mdouchement/Alembic-F2b/VPump/README.md

# VPump

The TT VPUMP kit is a very effective working voltage converter which generates an output voltage of 90 V DC to 220 V DC  from a 12V DC input voltage.
The circuit is in use for many years now and it is proven. In this kit the circuit has been adapted to a compact size and optimized for use in small preamplifier chassis. So it is an ideal HV power supply for tube stompboxes and preamps without the need of additional transformers and HV filter capacitors.

The VPump can be operated with a standard 12V DC switching power supply.
The switching power supply is not included in the kit. 

## Specification

Input Voltage: 12 V DC @ min 4 VA
Output Voltage: 90 - 220 V DC, adjustable
Output Current: 15 mA @ 220 V DC max 

## Link

https://www.tube-town.net/ttstore/tt-vpump-voltage-converter.html
