mdouchement/Alembic-F2b/potentiometer.png

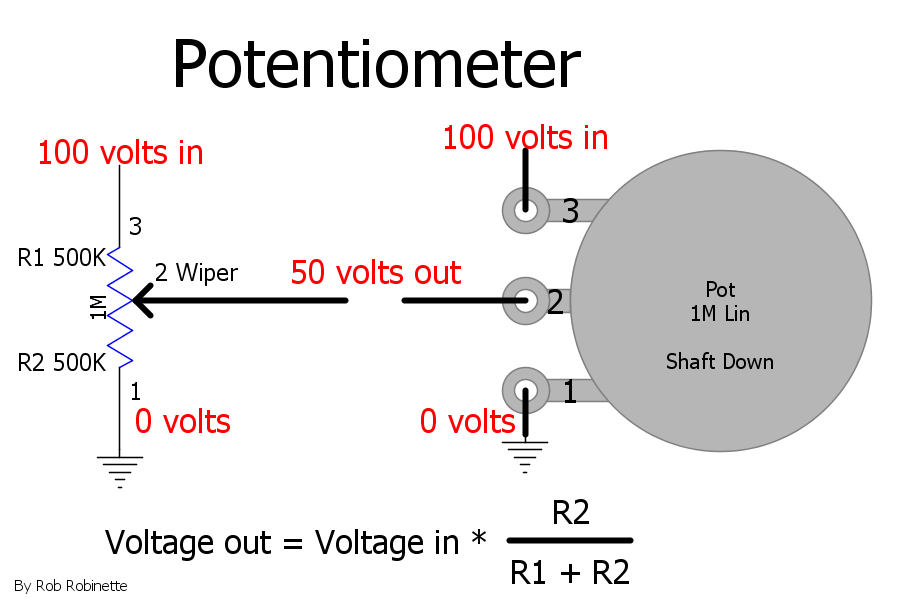
potentiometer.png
