mdouchement/Alembic-F2b/Alembic_F2b_bass_preamp_layout.pdf

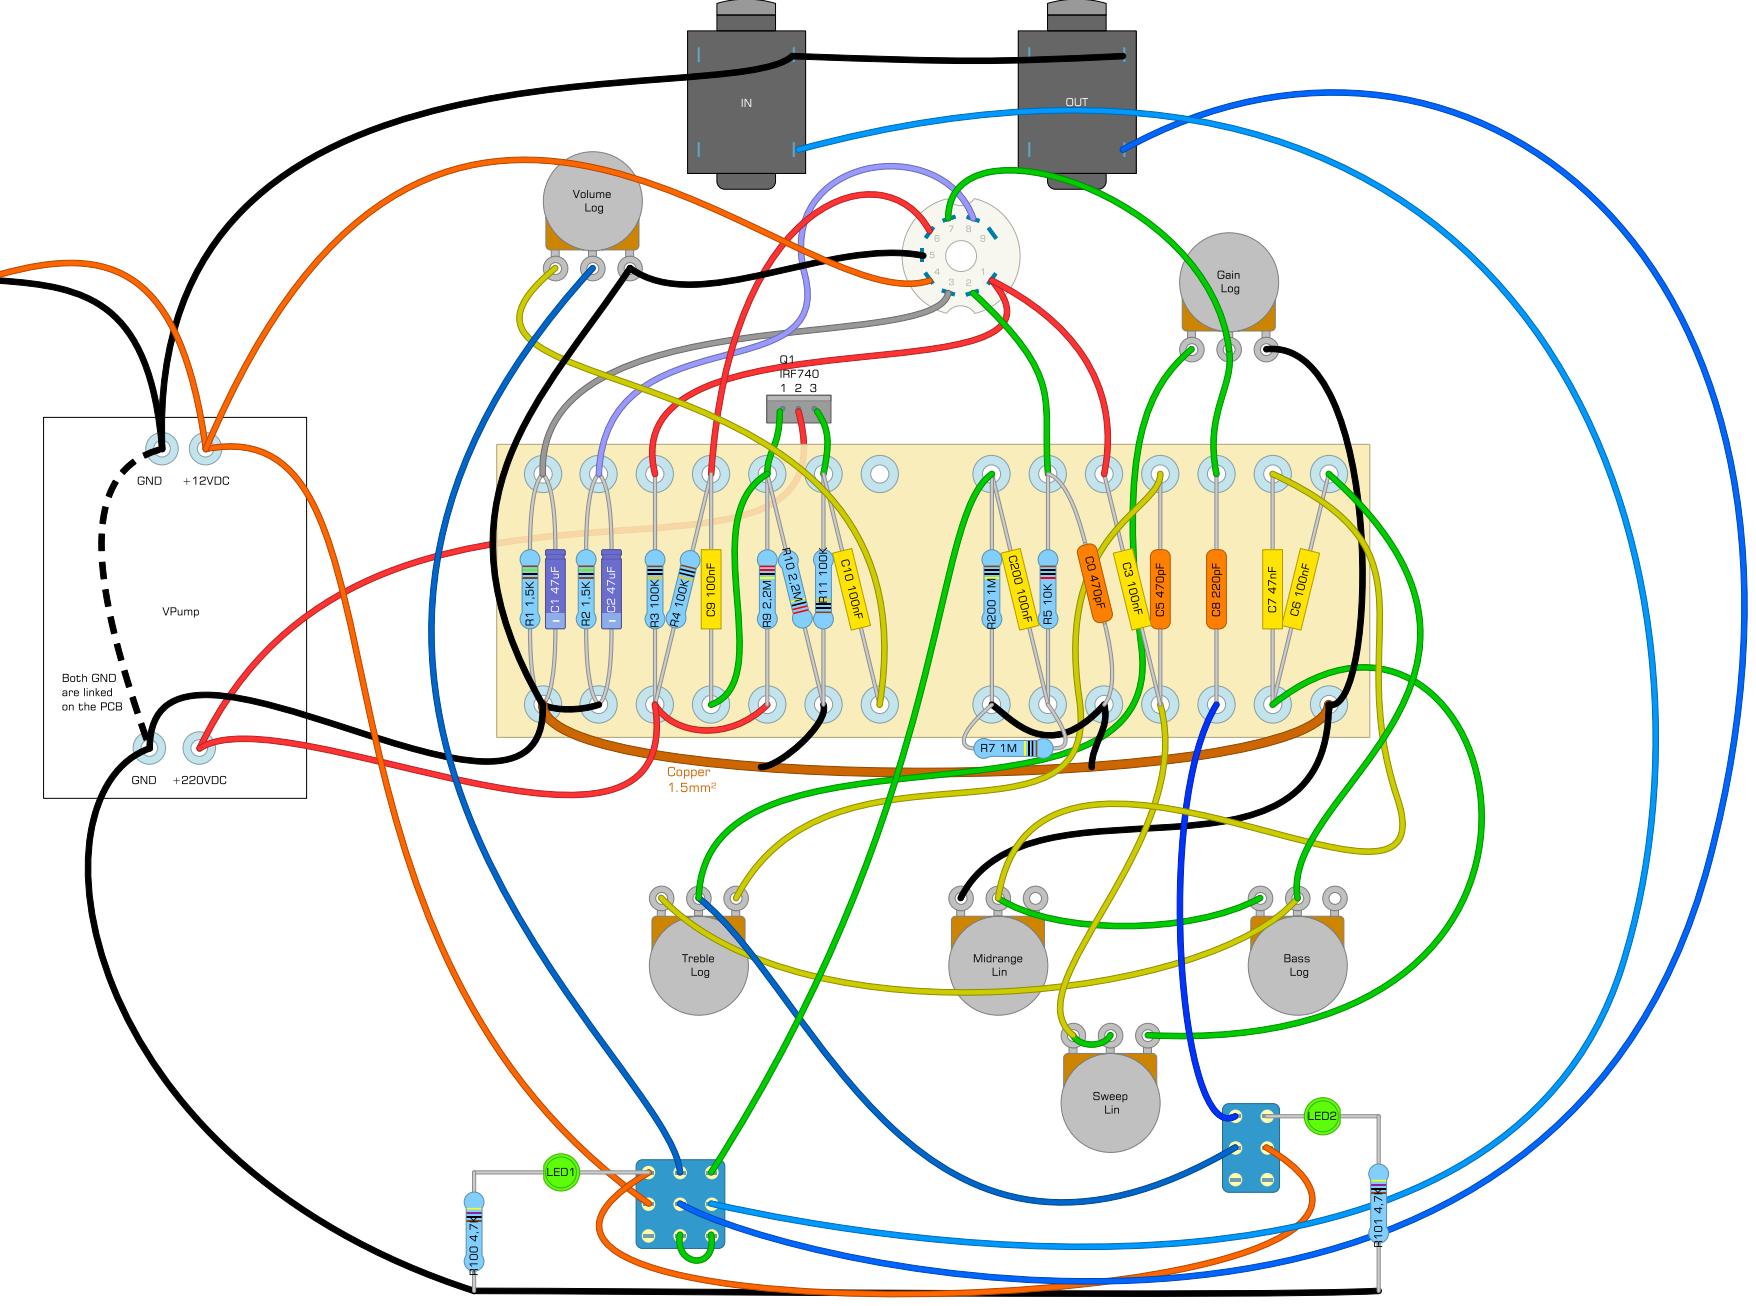
[picture p3: page 1]
