mdouchement/Alembic-F2b/Alembic_F2b_bass_preamp_schema.pdf

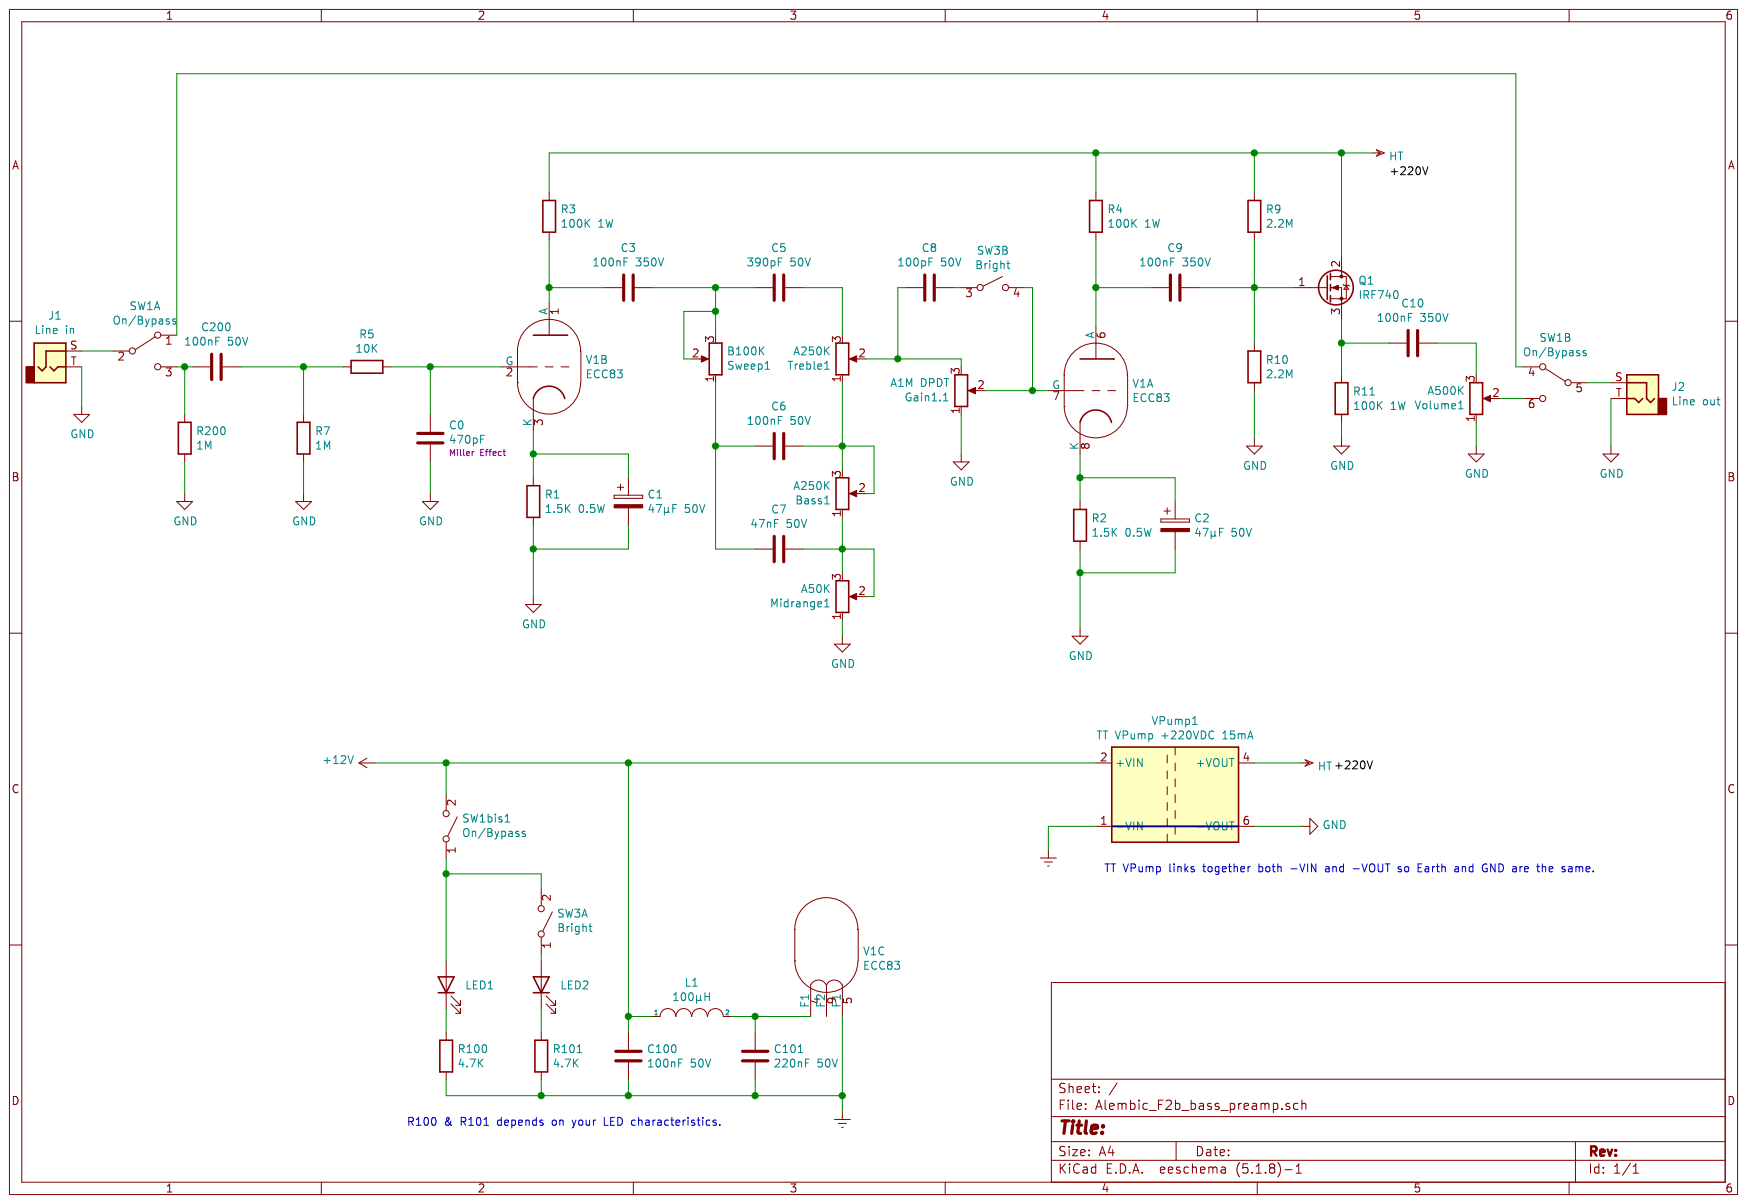
[picture p4: page 1]
