mdouchement/Alembic-F2b/VPump/vpump_layout_v1_6.pdf

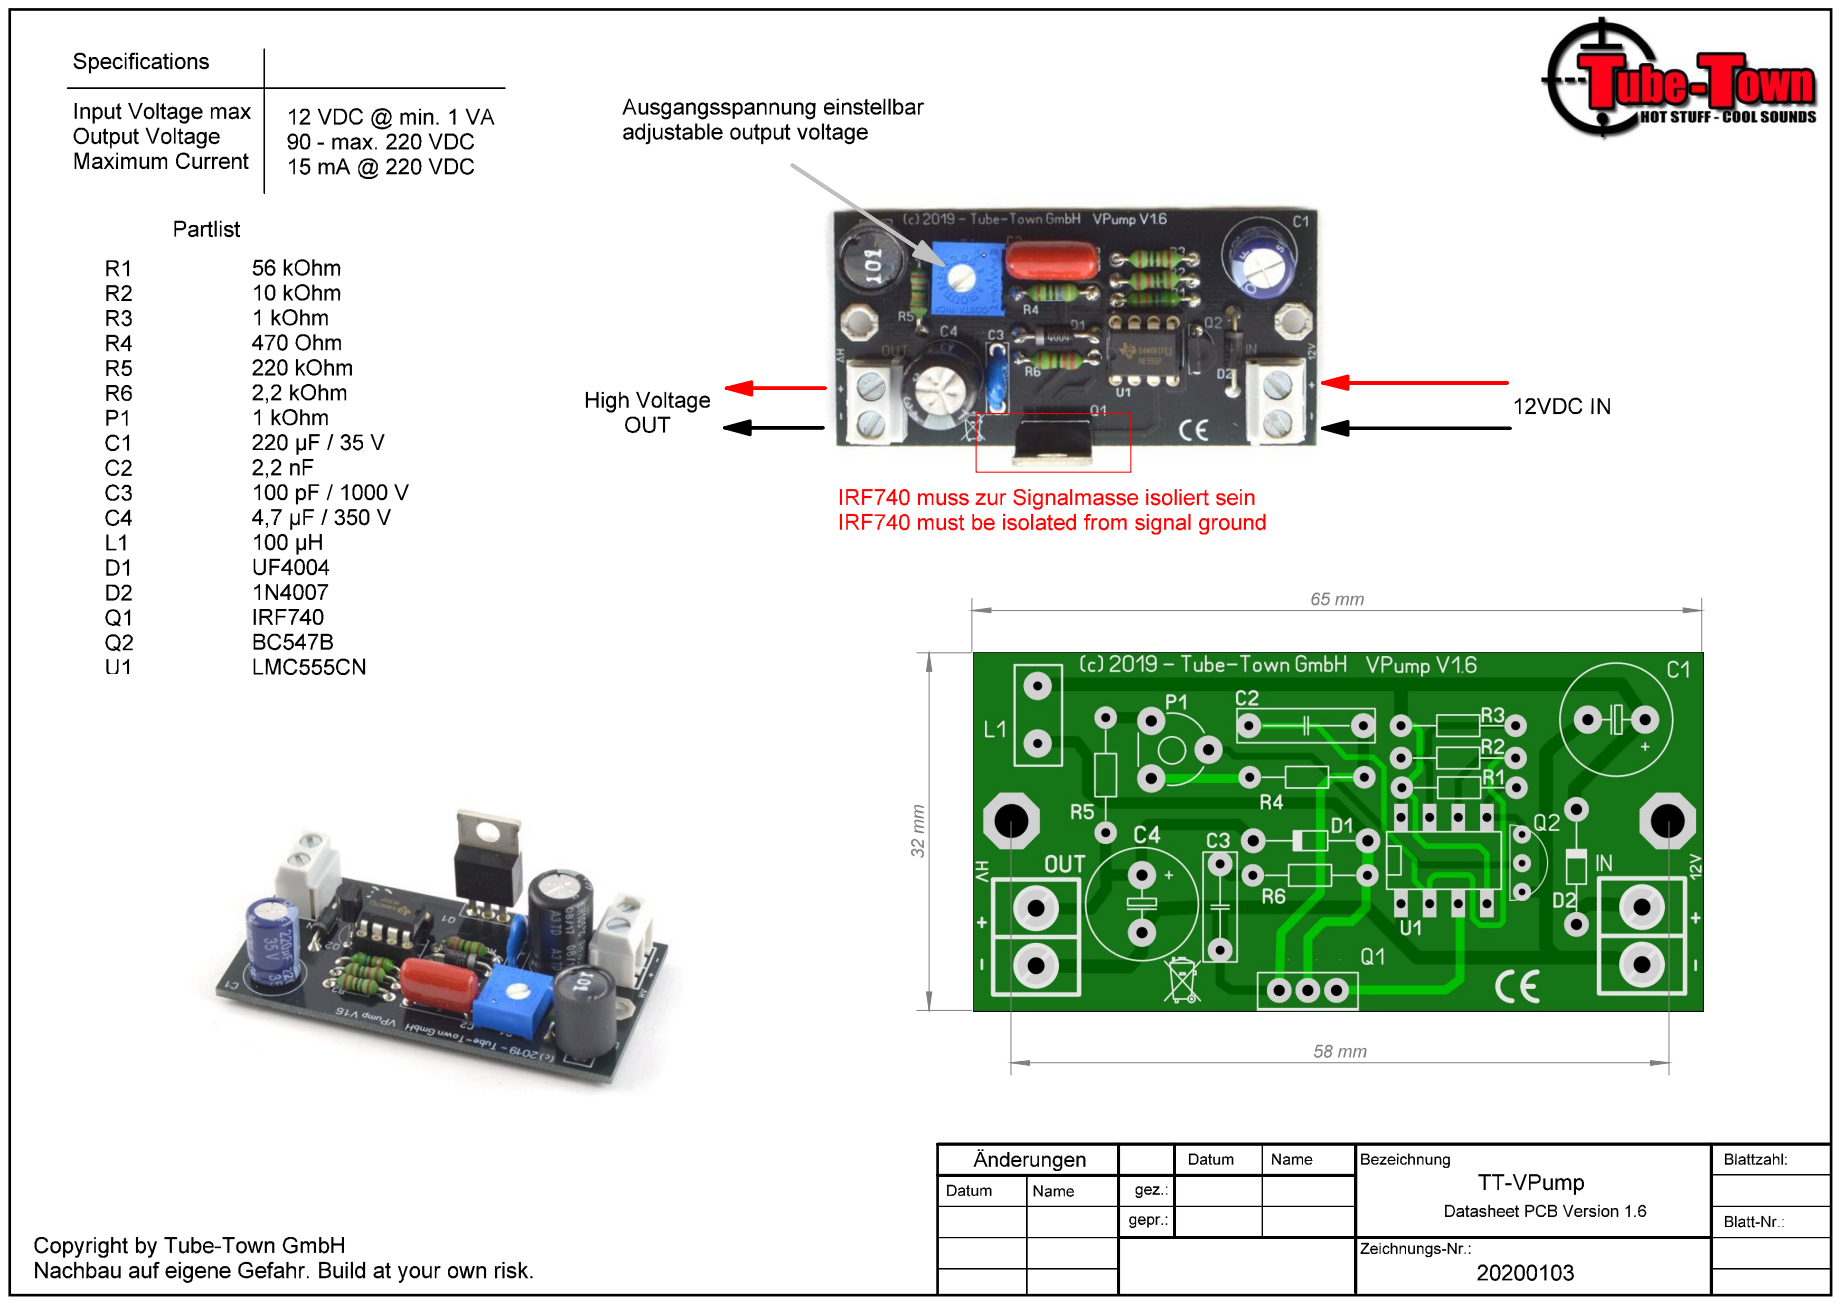
[picture p5: page 1]
