mdouchement/Alembic-F2b/F2B_manual.pdf

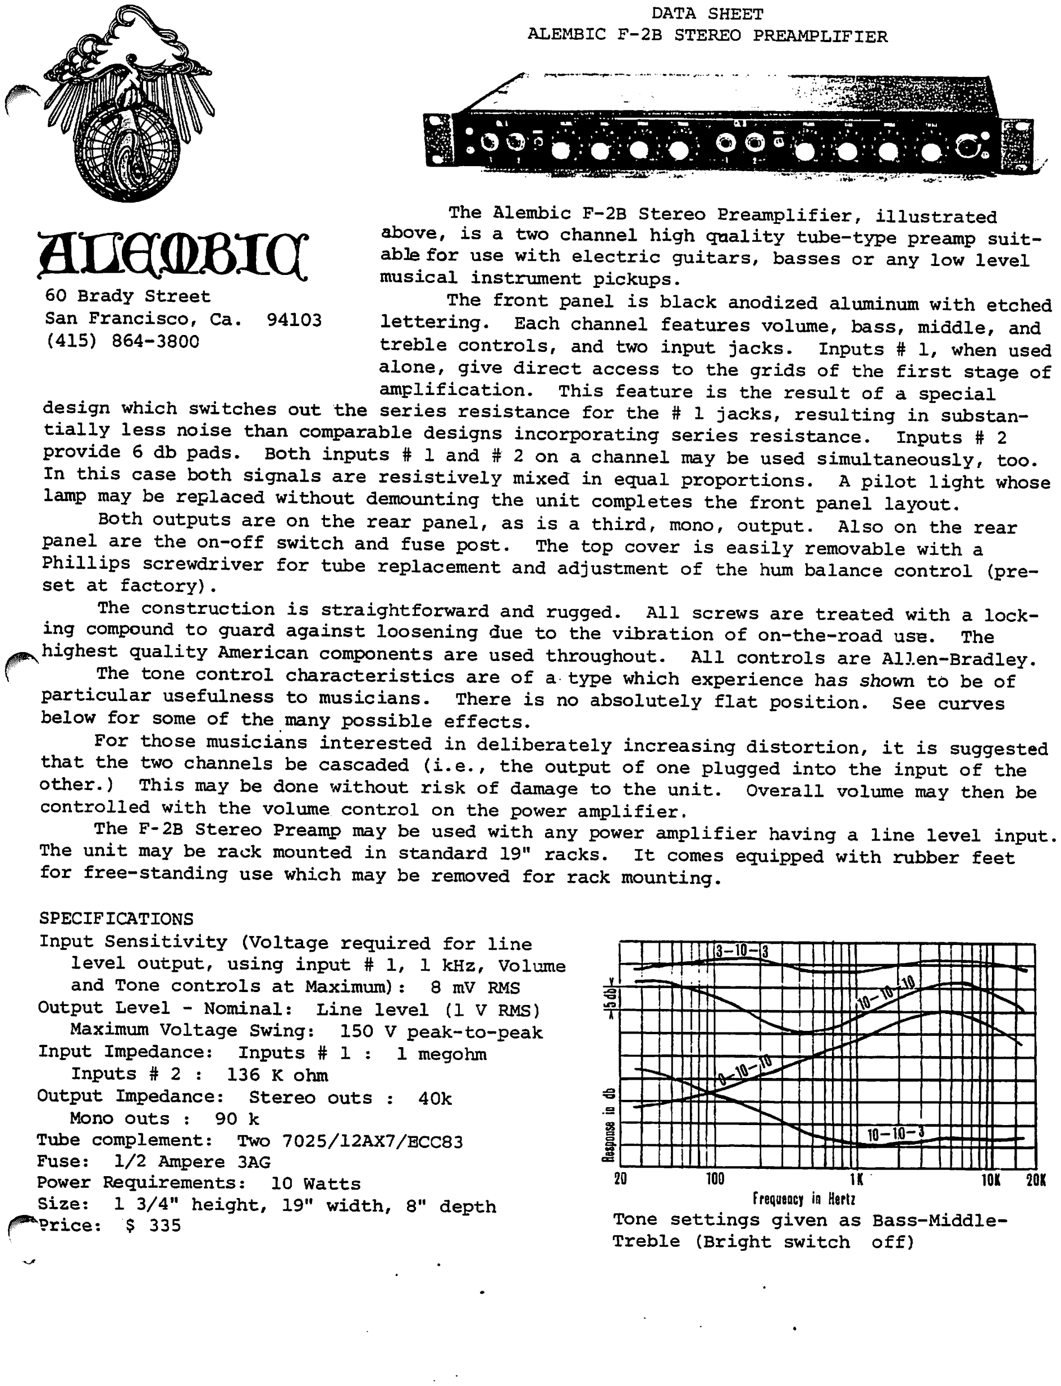
[picture p6: page 1]
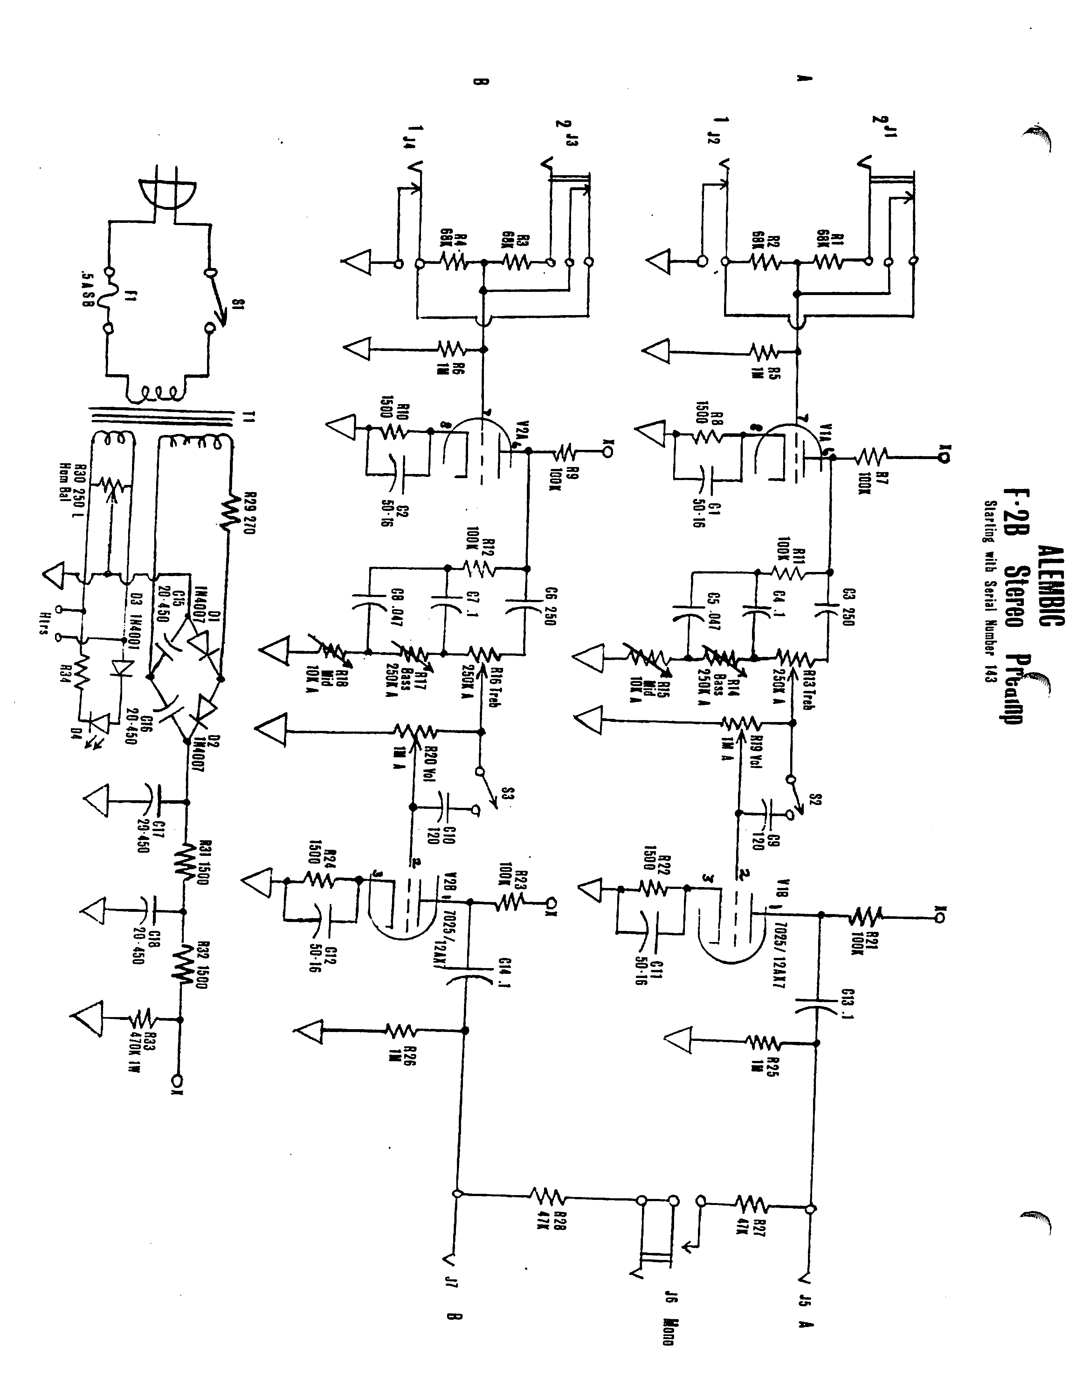
[picture p7: page 2]
